Pocket-EC/Voyager-v3.0-Files/Bill of Materials (BoM).xlsx

Voyager v3.0 - M2888B2 Assembly
Designator | Comment | Description | Supplier | Supplier Part Number | Quantity | Job Quantity | Layer
C5, C11, C12, C13, C14 | 100nF-0603 | 0603 capacitor | Farnell | 1362556 | 5 | 40 | Bottom
C6 | 22nF-0603 | 0603 capacitor | Farnell | 2581056 | 1 | 8 | Bottom
C8, C9 | 18pF-0603 | 0603 capacitor | Farnell | 1414620 | 2 | 16 | Bottom
C10 | 10uF-0603 | 0603 capacitor | Farnell | 2494233 | 1 | 8 | Bottom
C15 | NP-C | 0603 capacitor, non populated | Farnell | 2494233 | 1 | 8 | Bottom
C16 | 4u7F-0603 | 0603 capacitor | Farnell | 2426960 | 1 | 8 | Bottom
L1 | NLFV32T-102K-EF | High frequency inductor, 20mA, 1210 | Farnell | 2407460 | 1 | 8 | Bottom
P3 | 5w 52207 1.00mm | FPC top contact, 1.00mm, 52207 series | Farnell | 1757073 | 1 | 8 | Bottom
R4, R9, R10 | 10k-0603 | 0603 resistor | Farnell | 9238603 | 3 | 24 | Bottom
R5 | 470R-0603 | 0603 resistor | Farnell | 9238441 | 1 | 8 | Bottom
R11 | NP-R | 0603 resistor | Farnell | 2145375 | 1 | 8 | Bottom
SL1 | Solder Link NO | Solder Link, normally open |  |  | 1 | 8 | Bottom
U3 | LM4120AIM5-2.5 | Low Dropout Voltage Reference | Farnell | 9778799 | 1 | 8 | Bottom
U4 | PIC24FJ128GA306-I/PT | Microcontroller | Digi-Key | PIC24FJ128GA306-I/PT-ND | 1 | 8 | Bottom
U6 | LMP91000SDE/NOPB | AFE Potentiostat | Farnell | 1872933 | 1 | 8 | Bottom
X1 | ABM8G-48 | SMD crystal | Farnell | 2101342 | 1 | 8 | Bottom
C1, C2, C17 | 4u7F-0603 | 0603 capacitor | Farnell | 2426960 | 3 | 24 | Top
C3 | 10nF-0603 | 0603 capacitor | Farnell | 2407337 | 1 | 8 | Top
C4, C7 | 10uF-0603 | 0603 capacitor | Farnell | 2494233 | 2 | 16 | Top
D1 | MBRA140 | Schottky Diode | Farnell | 1651133 | 1 | 8 | Top
D2, D4 | SML-D15U2WT86C | RED 0603 LED, 20mA | Farnell | 2687495 | 2 | 16 | Top
D3, D5 | SML-D12P8WT86C | GRN 0603 LED, 20mA | Farnell | 2687486 | 2 | 16 | Top
P1 | 2w JST horiz | JST horizontal 2mm header | Farnell | 9492615 | 1 | 8 | Top
P2 | 5w header |  | Farnell | 1125360 | 1 | 8 | Top
R1 | 470R-0603 | 0603 resistor | Farnell | 9238441 | 1 | 8 | Top
R2 | 2k-0603 | 0603 resistor | Farnell | 1469764 | 1 | 8 | Top
R3, R6, R8 | 150R-0603 | 0603 resistor | Farnell | 1738893 | 3 | 24 | Top
SW1 | EVP0AFB65 | Push to make, momentray action switch | Farnell | 2425606 | 1 | 8 | Top
SW2 | A6S-1104-H | 1way SIL switch (slide) | Farnell | 1960892 | 1 | 8 | Top
U1 | MCP73831T-2ATI/OT | Charge Management Controller, 4.2V | Farnell | 1834890 | 1 | 8 | Top
U2 | ADP1715ARMZ-3.3-R7 | CMOS Linear Regulator | Farnell | 2376927 | 1 | 8 | Top
U5 | RN42-I/RM | Bluetooth module | Farnell | 2143310 | 1 | 8 | Top
