Pocket-EC/Voyager-v3.0-Files/Schematics.pdf

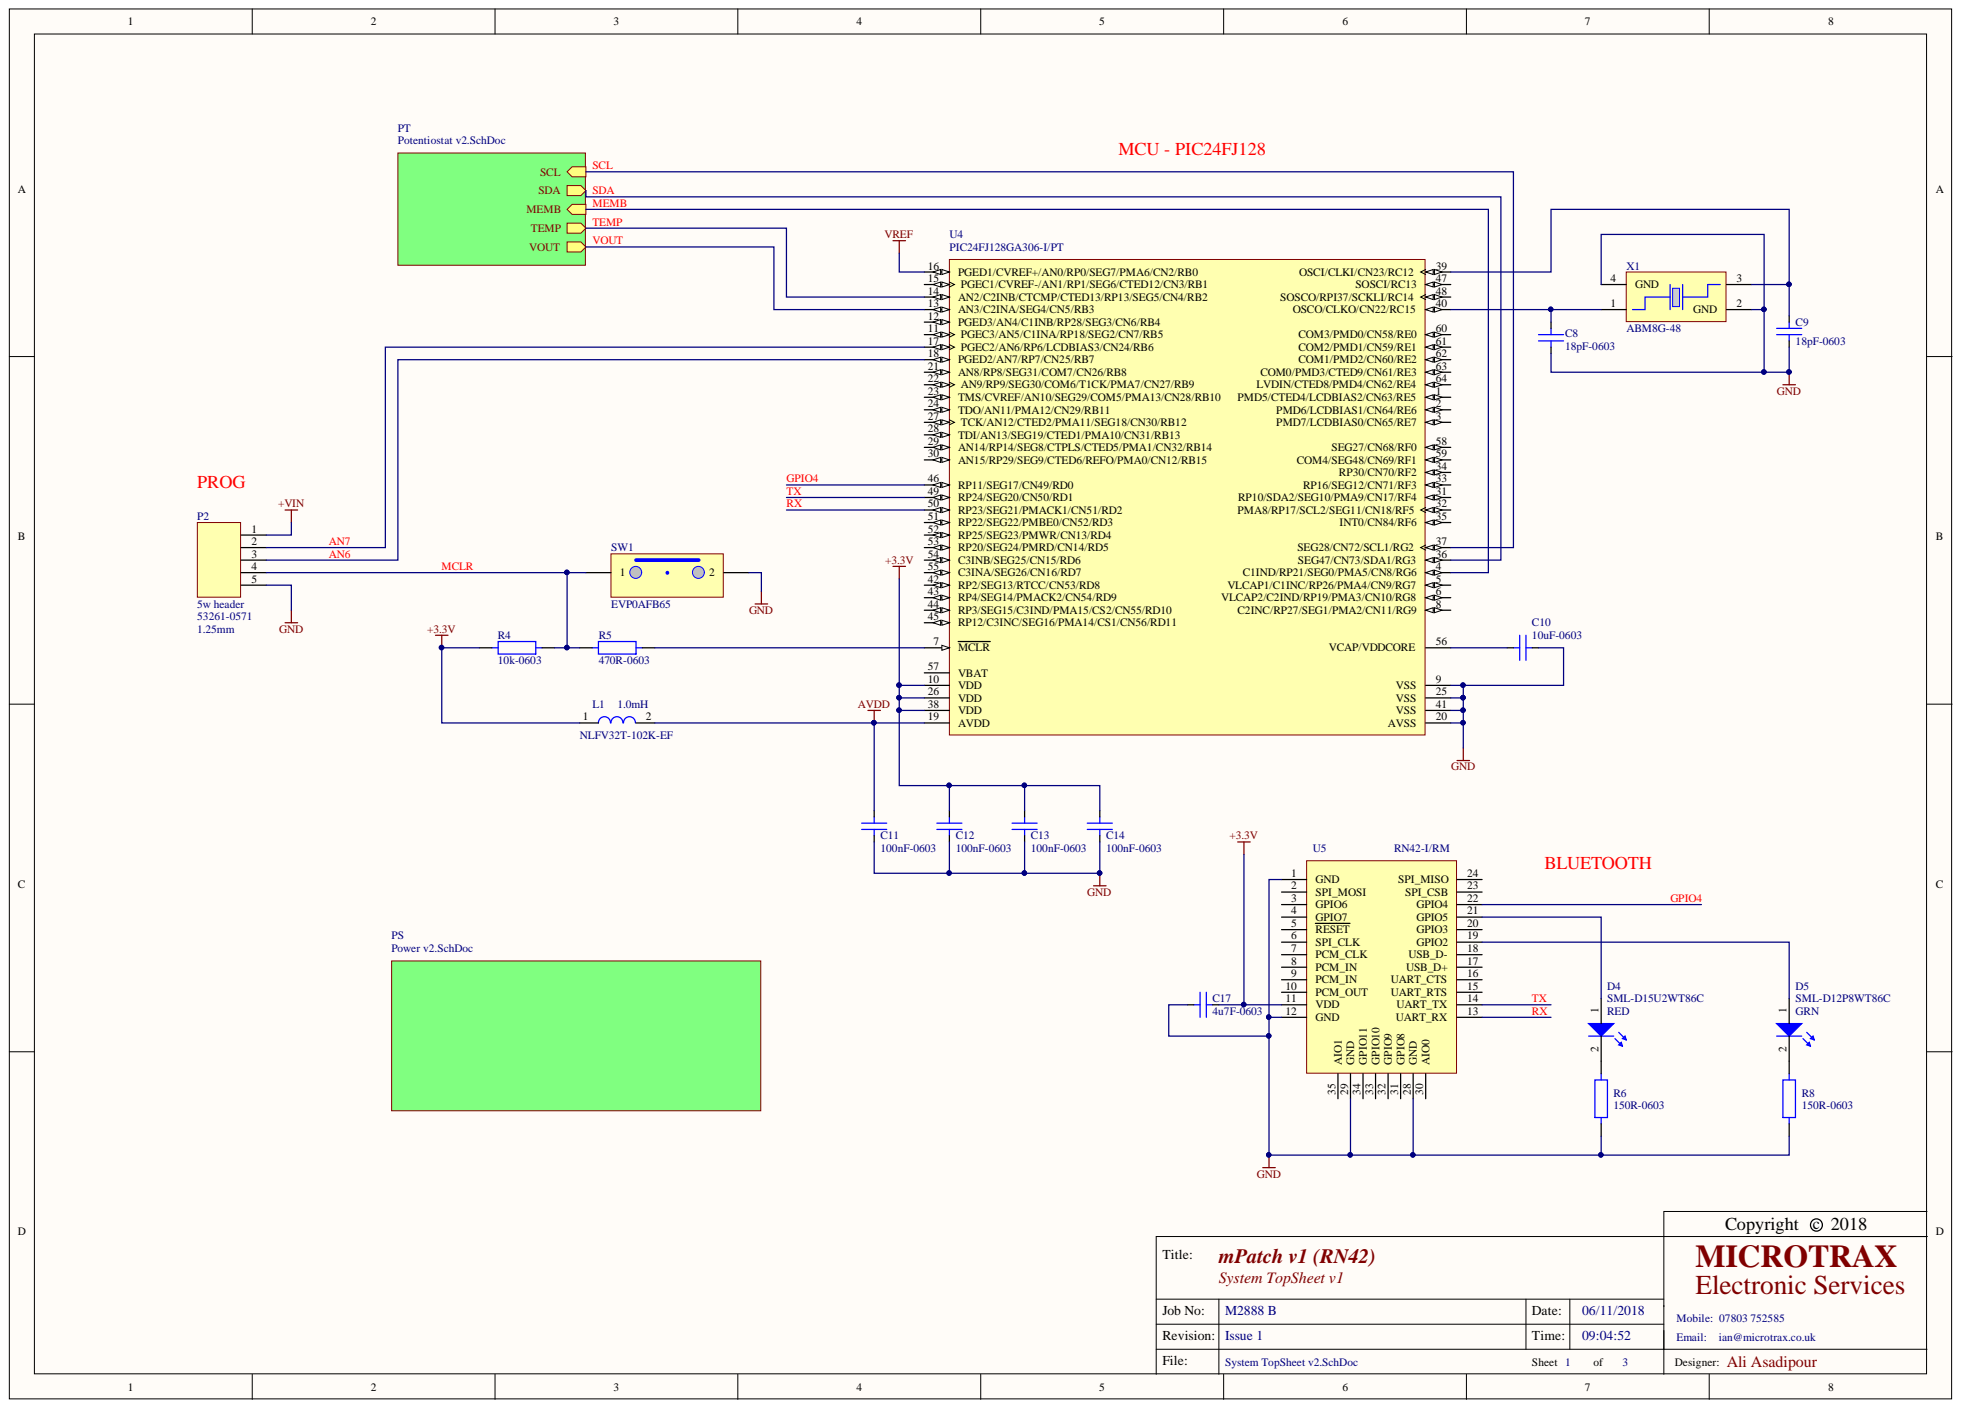
[picture p1: page 1]

Job No: | M2888 B | D a t e : | 06/11/2018

Revi s ion: | Is sue 1 | | 09:04:52

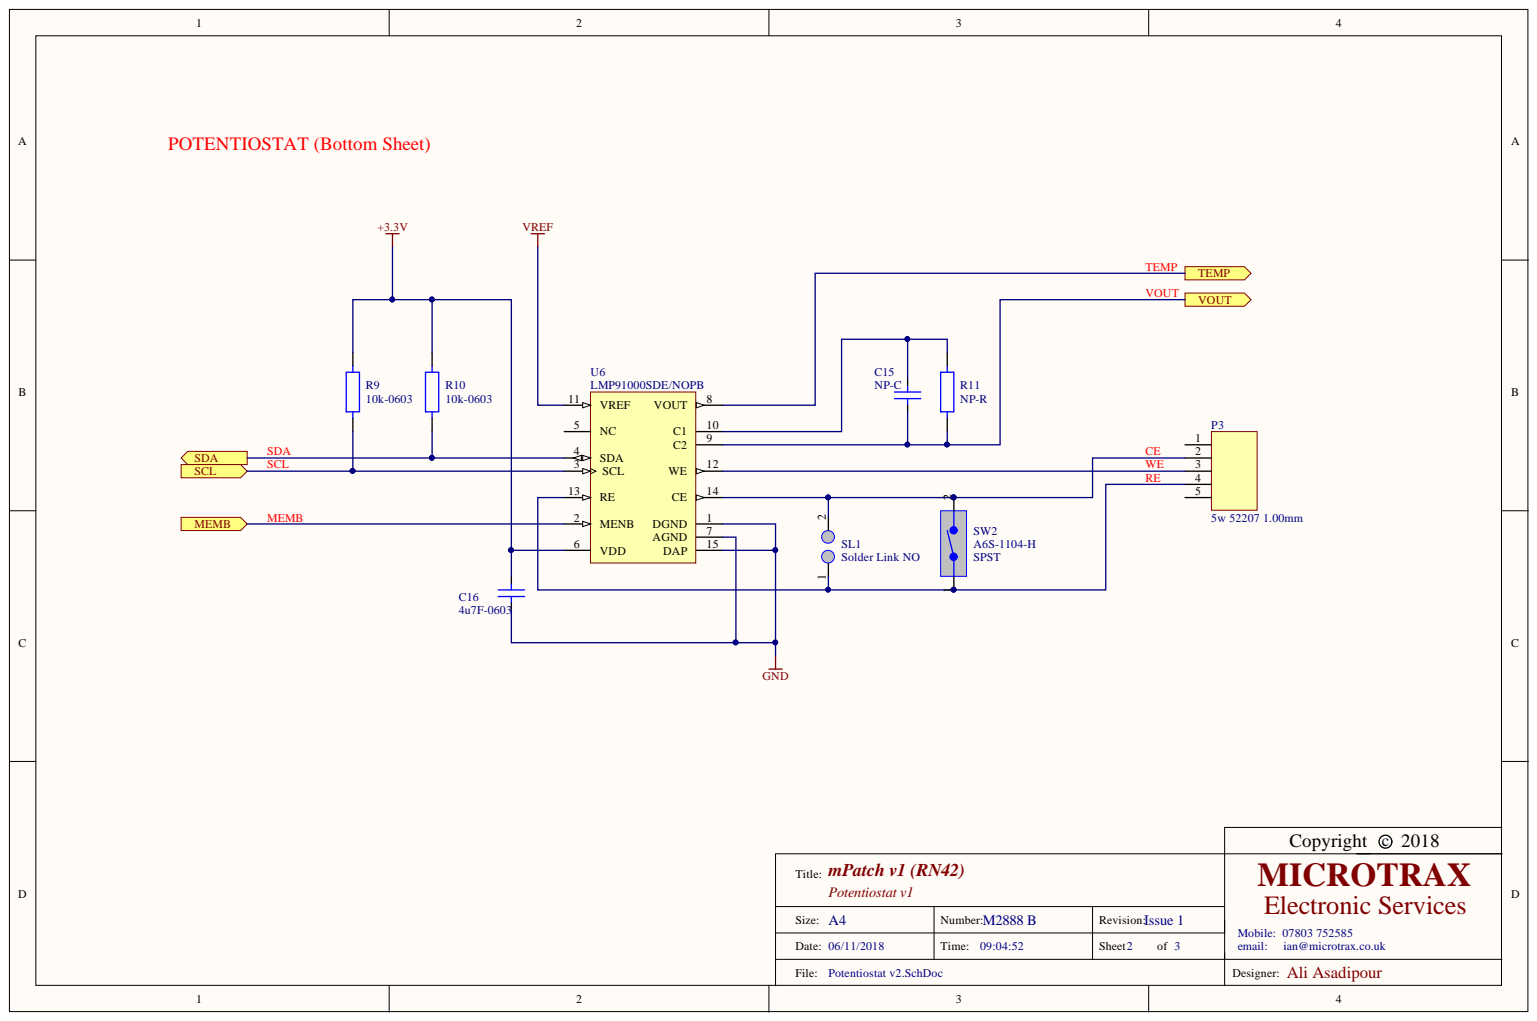
[picture p2: page 2]

1 5

mPatch v1 (RN42) T i t le: Pote ntiostat v 1 | MICROTRAX Electronic Services Mobile: 07803 752585 emai l : ian@micro

A4 Size: | M 2 8 8 8 B N umber: | Issu e 1 Rev i s i o n :

Date: 0 6 / 1 1 / 2 0 1 8 | T ime: 0 9 : 0 4 : 5 2 | Sheet 2 o f 3

Fi le: Po ten t i o s tat v 2.Sch D o c | Des i g ner: A l i

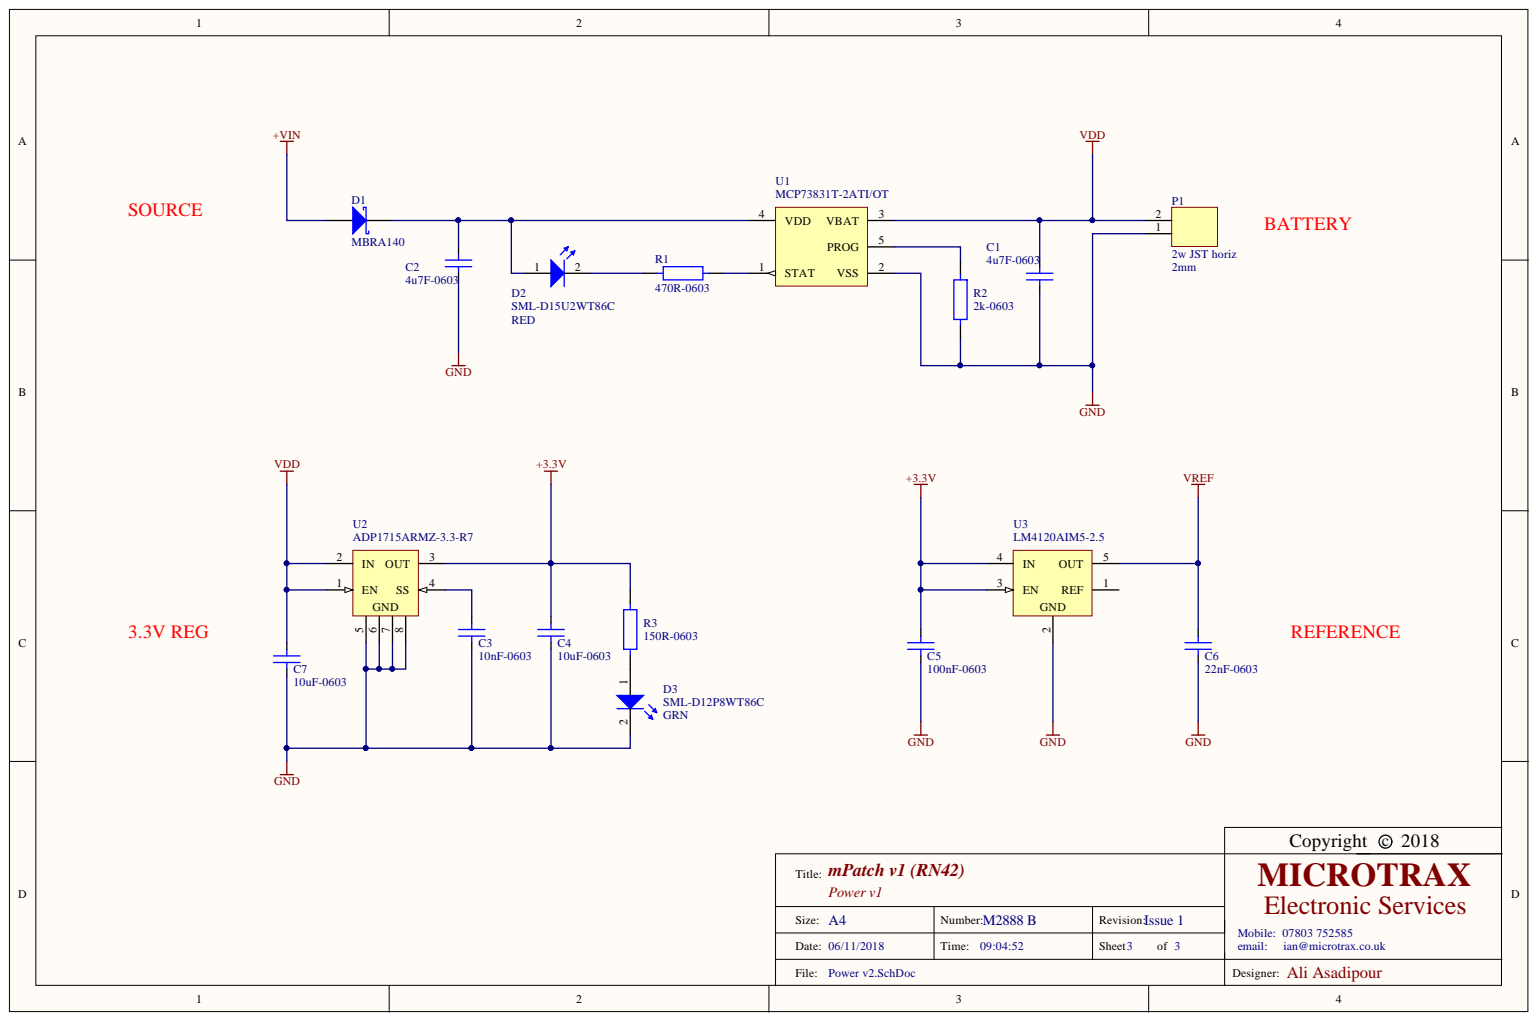
[picture p3: page 3]

mPatch v1 (RN42) Title: Power v1 | Electronic Services Mobile: 07803 752585

A4 Size: | M2888 B Number: | Issue 1 Revision:

Date: 06/11/2018 | Time: 09:04:52 | Sheet 3 of 3

File: Power v2.SchDoc

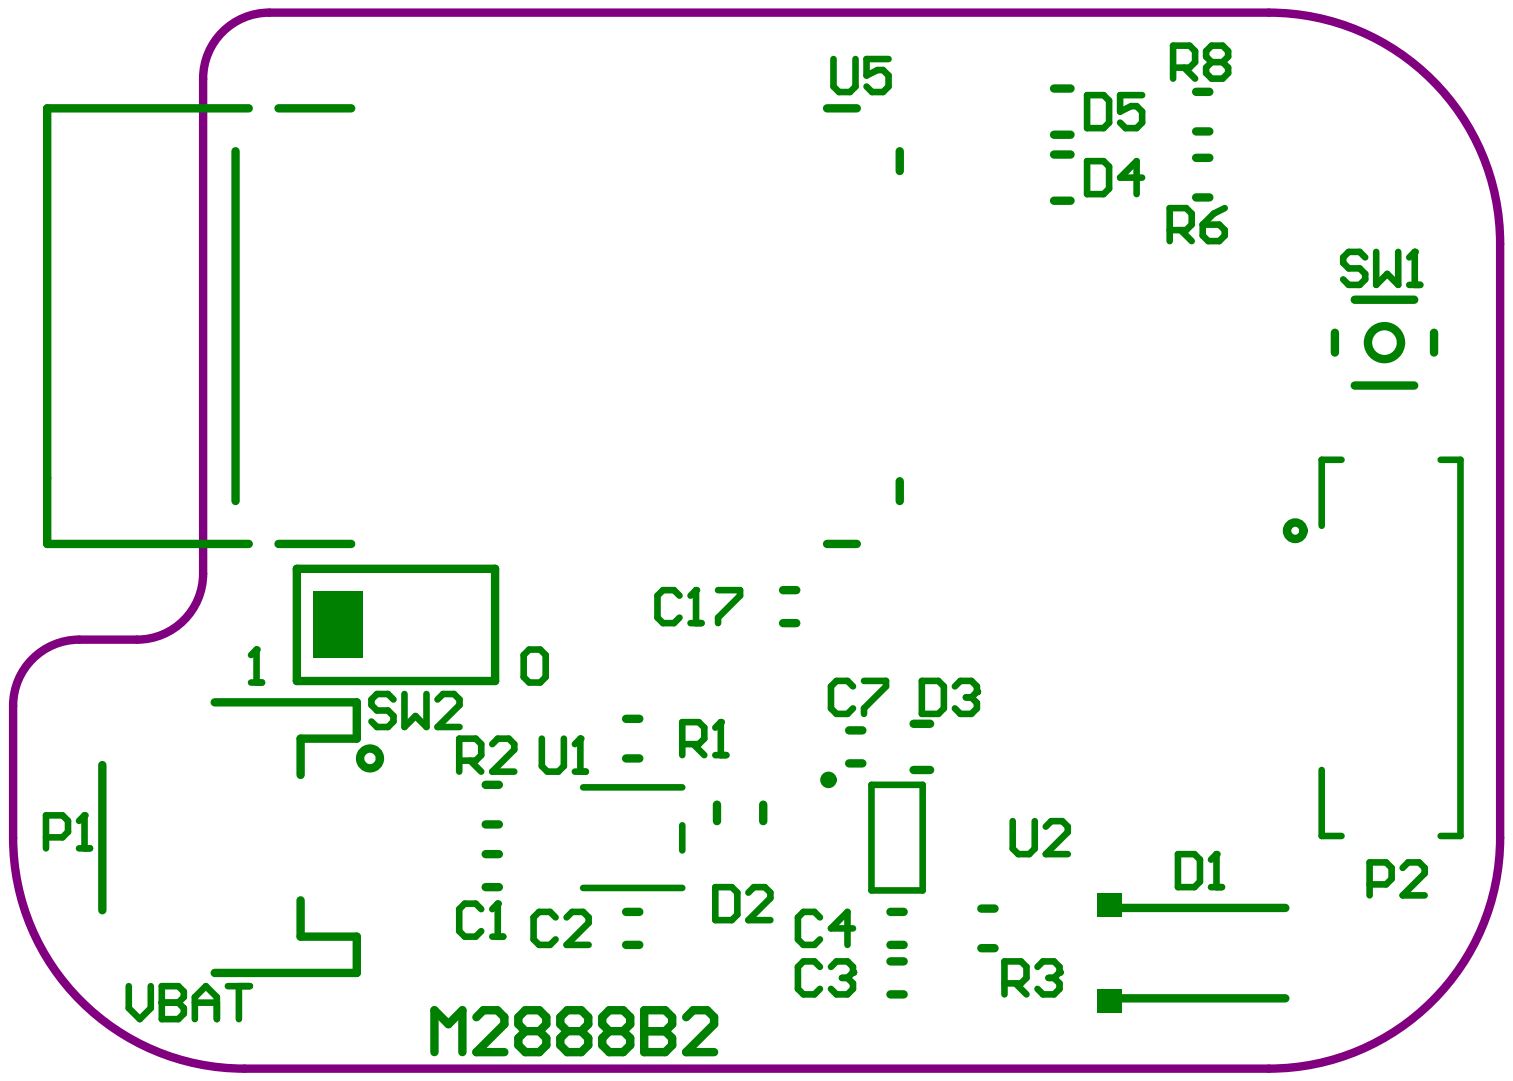
[picture p4: page 4]

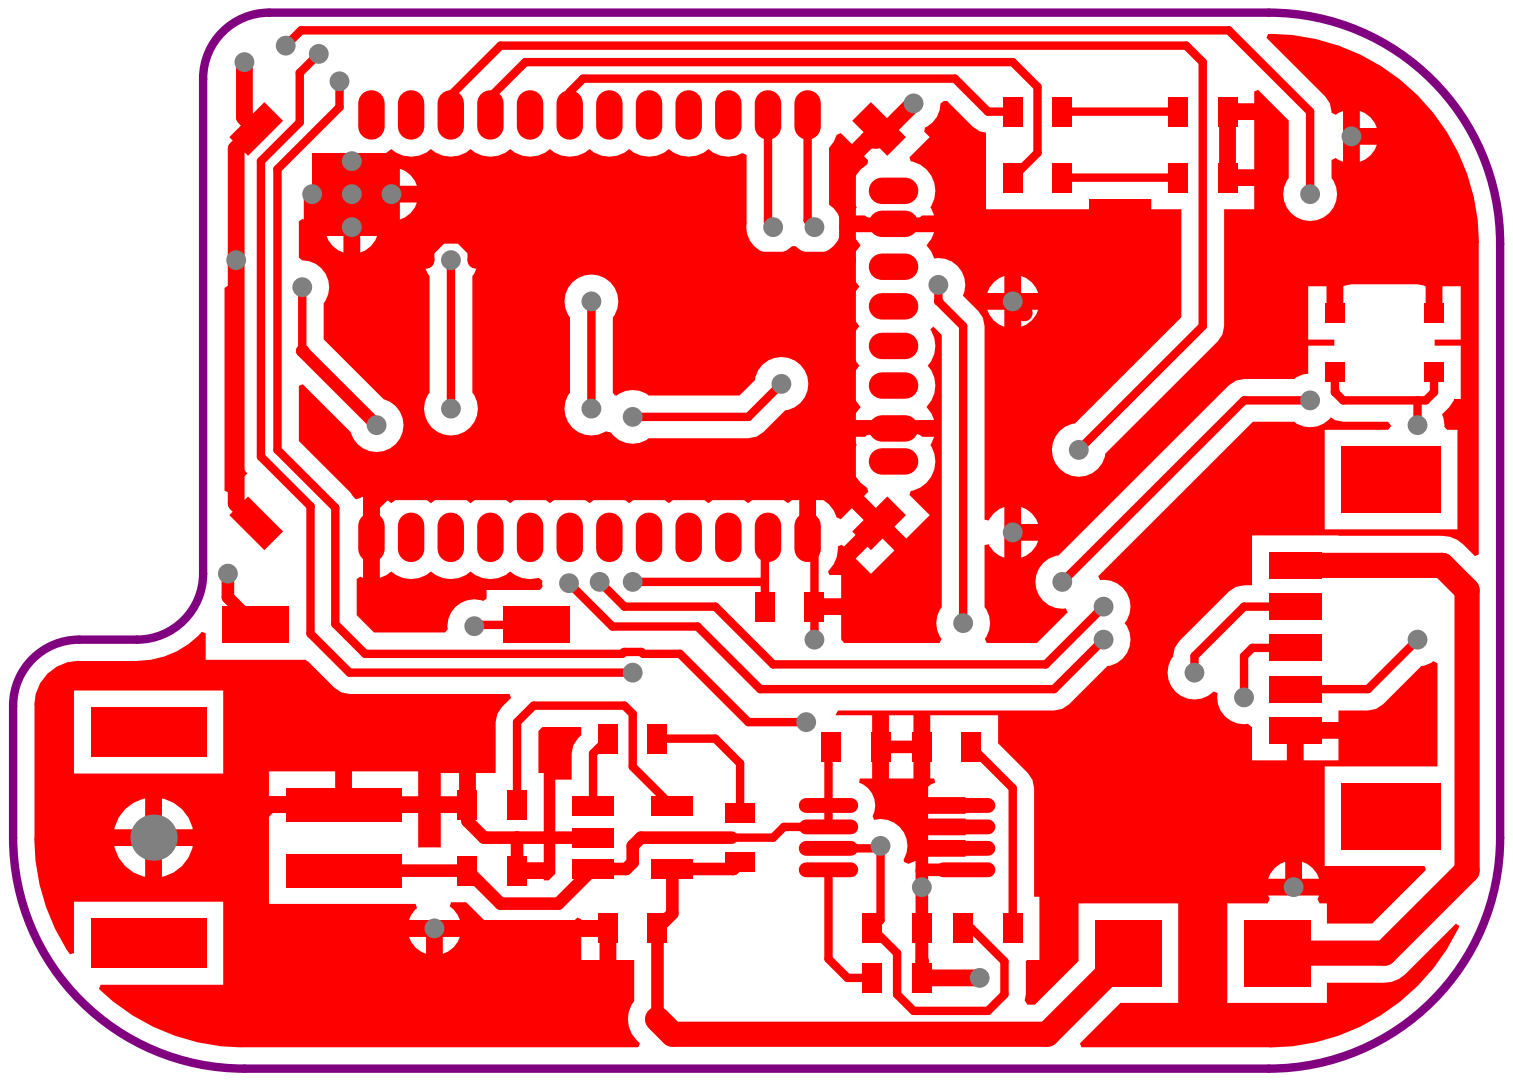
[picture p5: page 5]

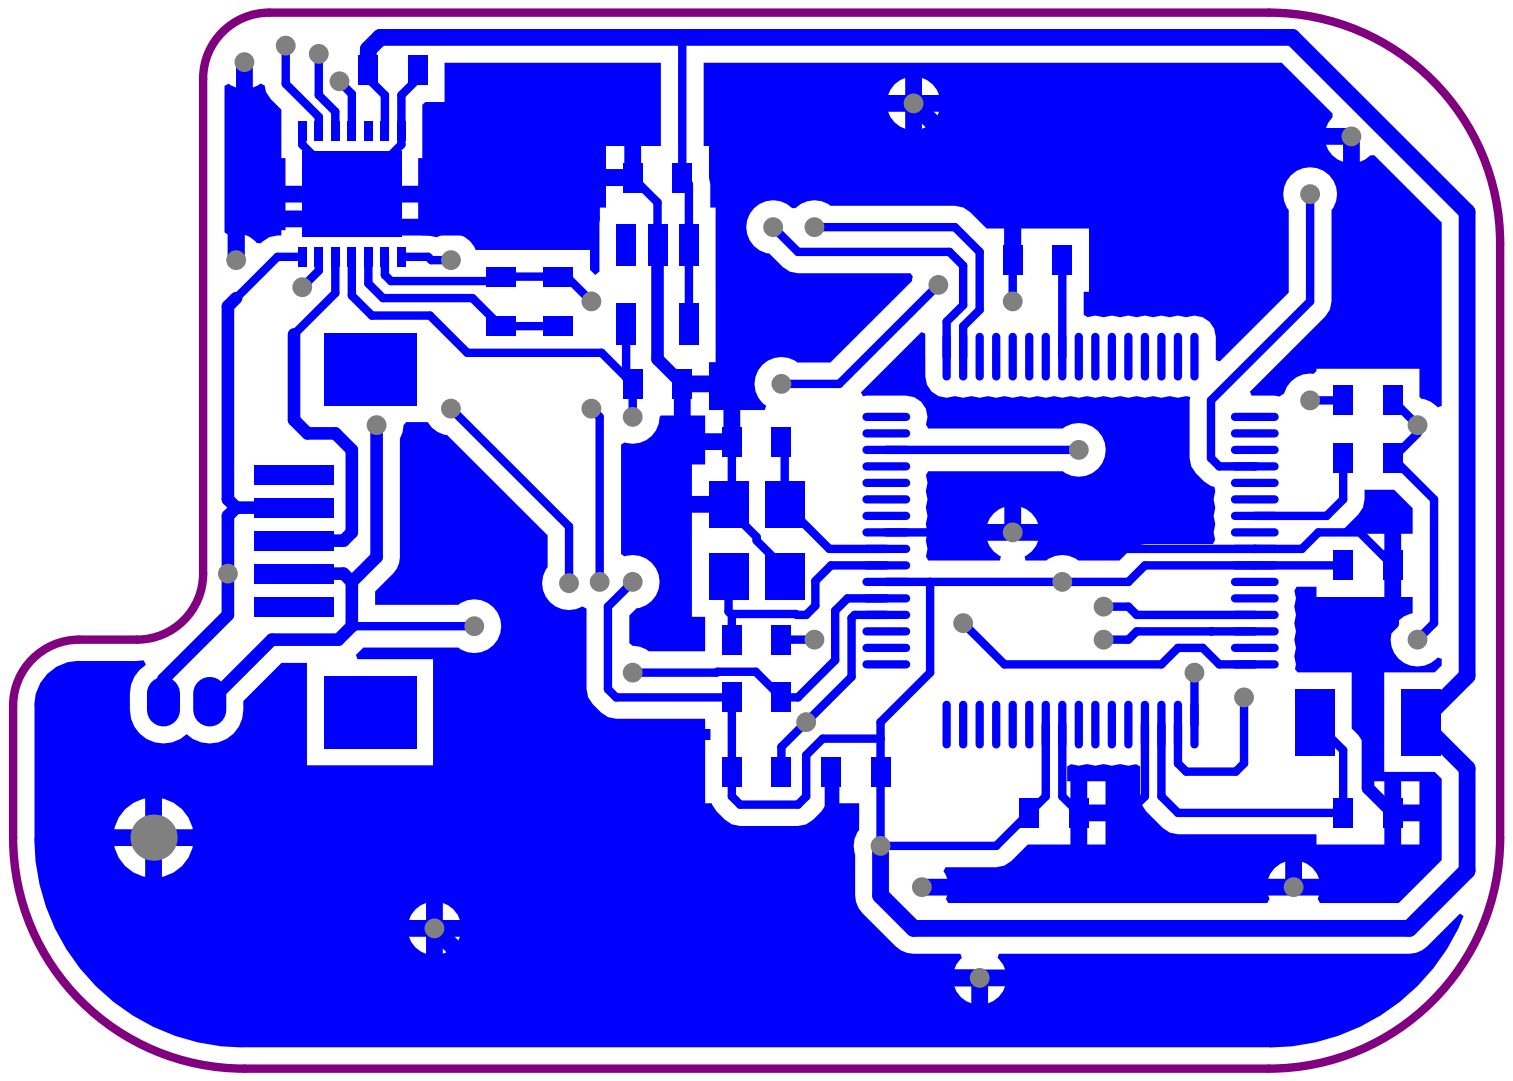
[picture p6: page 6]

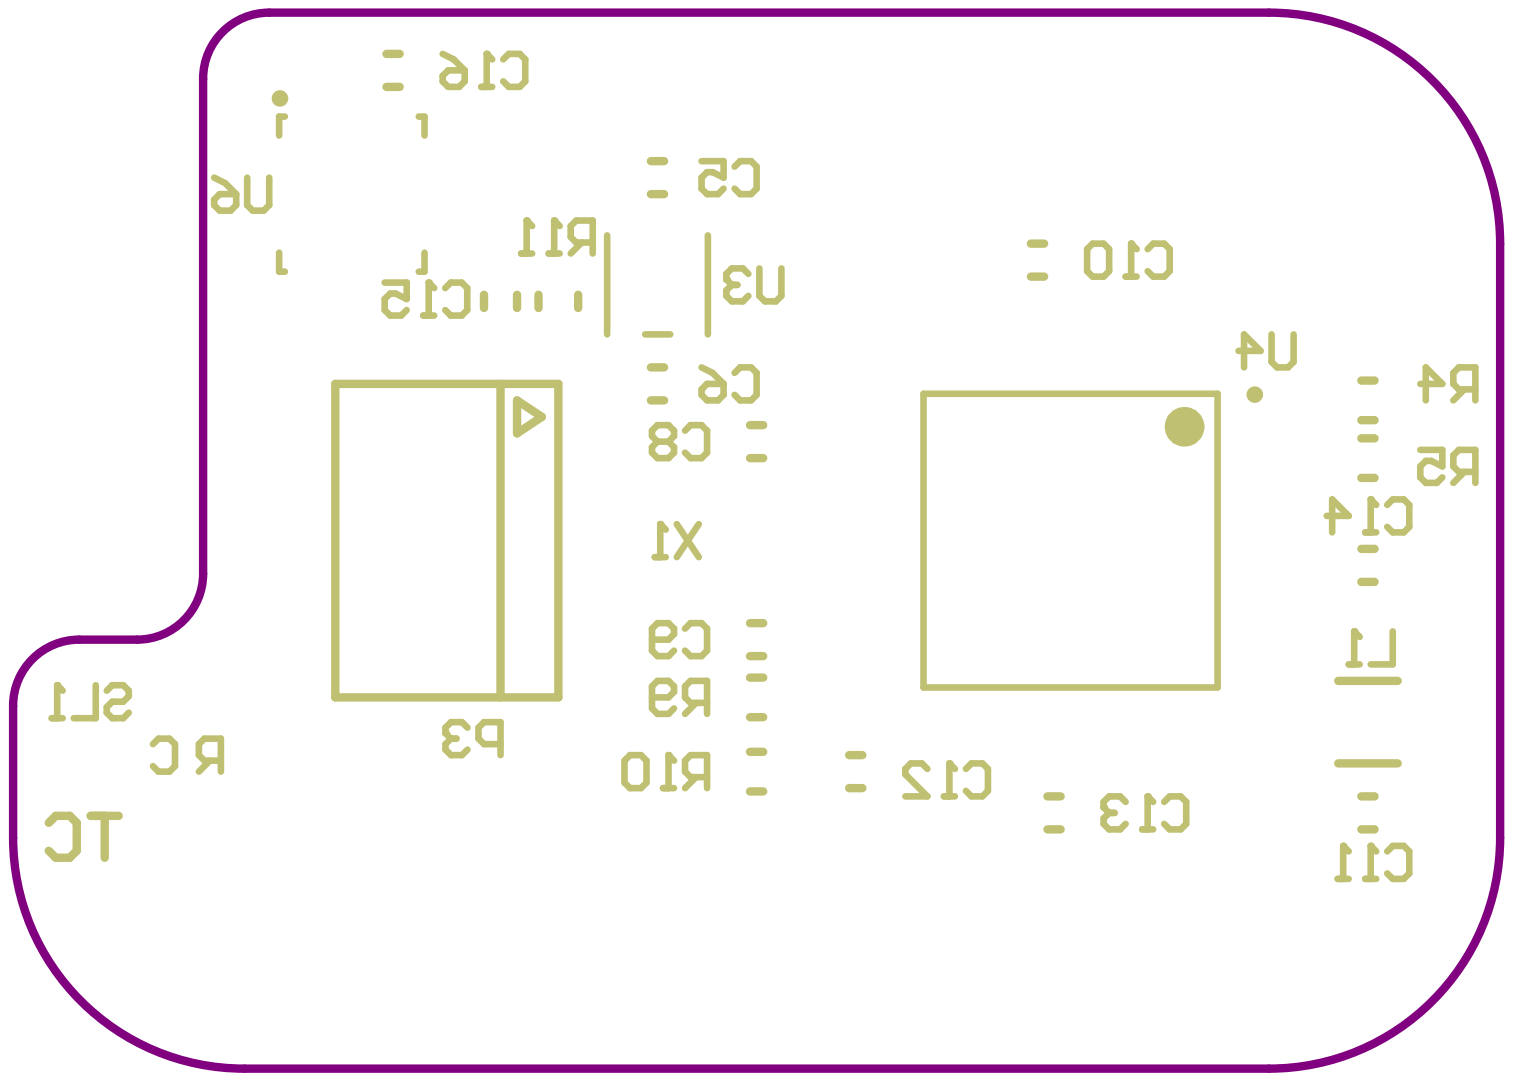
[picture p7: page 7]

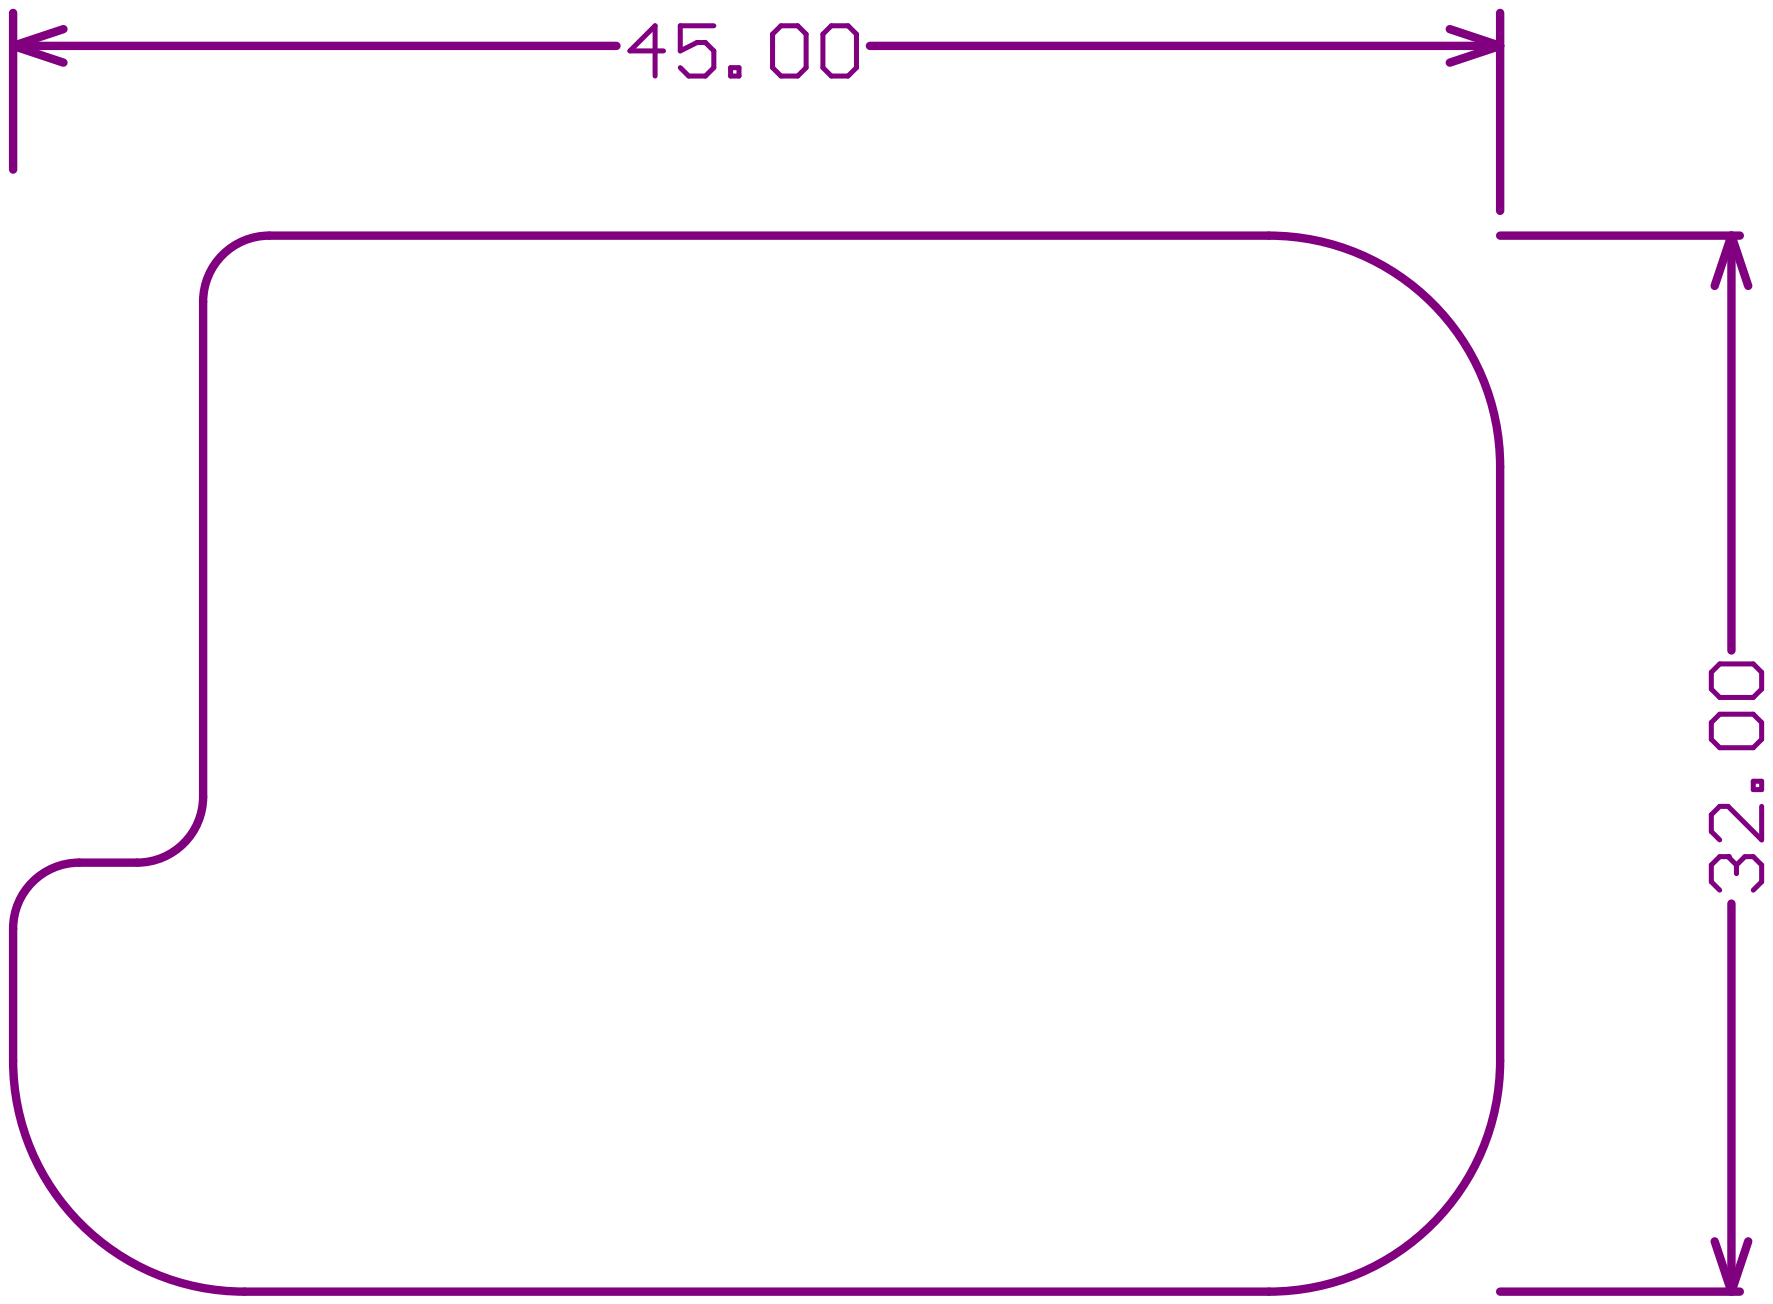
[picture p8: page 8]
